tue-minh/MM_Control/Board_Pinout.png

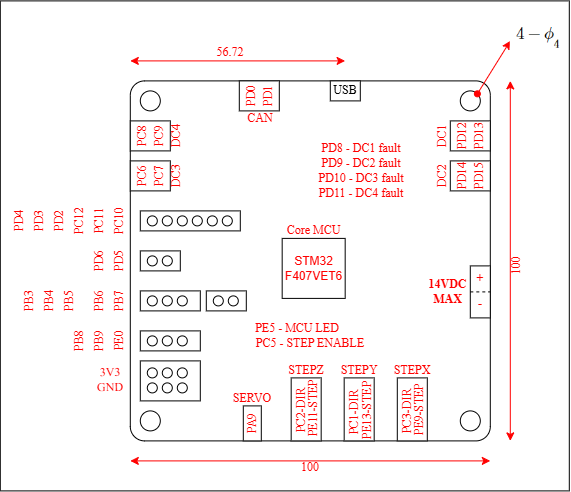
Board_Pinout.png
