tue-minh/MM_Control/hardware/Drawing1.dxf

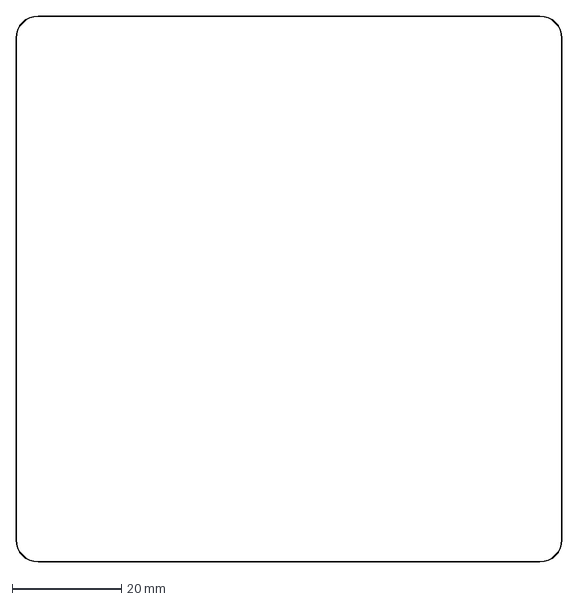
[picture p2: CAD file, 2026-09-20]
hardware/Drawing1.dxf
100.0 x 100.0 mm
