tue-minh/MM_Control/hardware/MM_Control.kicad_pcb

## KiCad design hardware/MM_Control.kicad_pcb (2026-09-20)

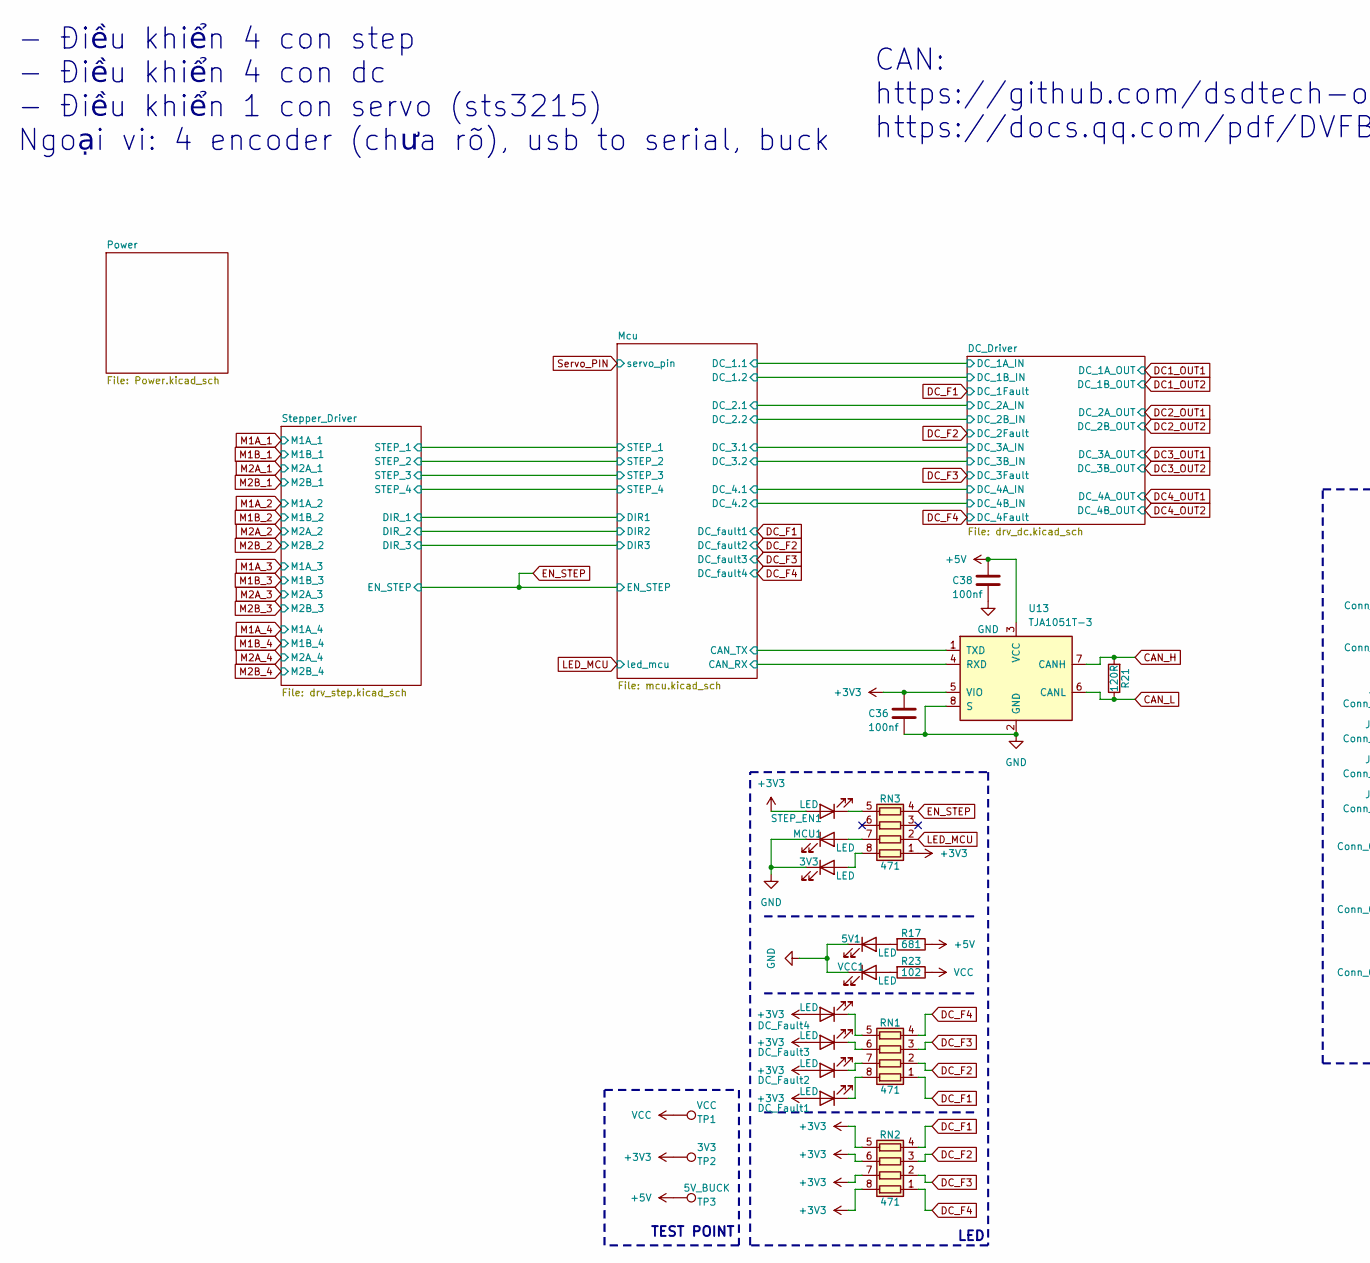
[picture p3: schematic MM_Control.kicad_sch, part in row 1, column 1]

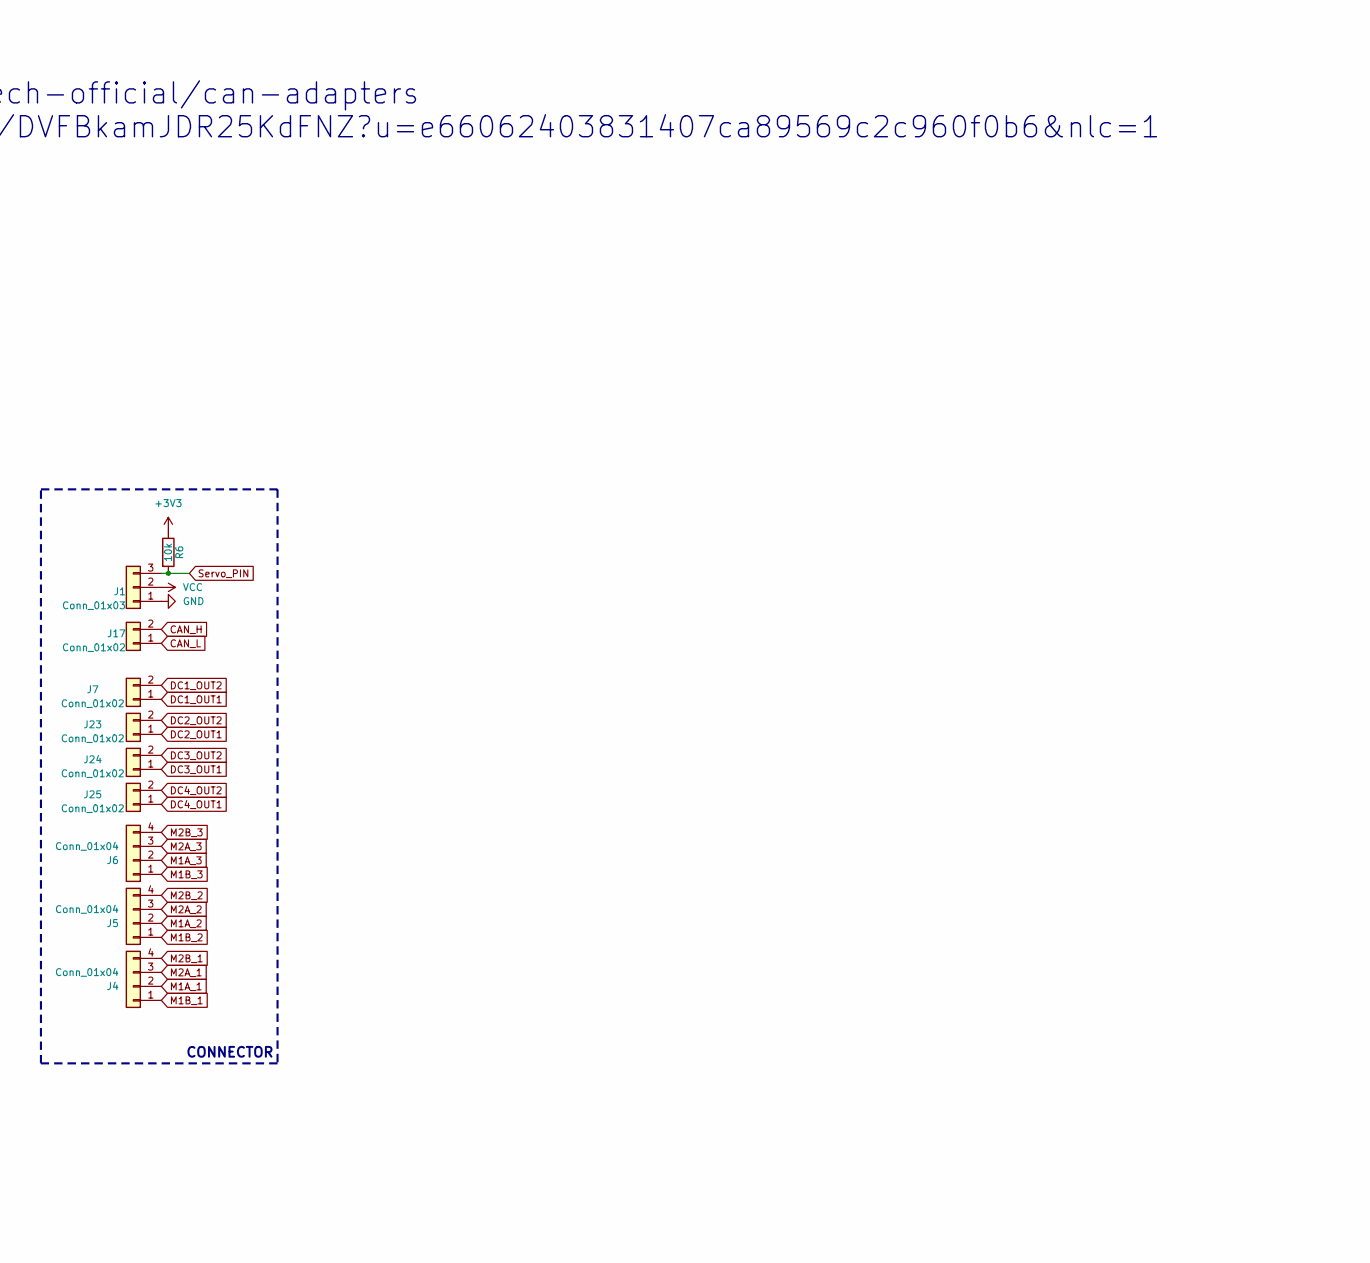
[picture p4: schematic MM_Control.kicad_sch, part in row 1, column 2]

Parts:
3V3, 5V1: LED; LED_0603_1608Metric_Pad1.05x0.95mm_HandSolder
C36, C38: 100nf; C_0603_1608Metric_Pad1.08x0.95mm_HandSolder
DC_Fault1, DC_Fault2, DC_Fault3, DC_Fault4: LED; LED_0603_1608Metric_Pad1.05x0.95mm_HandSolder
J1: Conn_01x03; Molex_SPOX_5267-03A_1x03_P2.50mm_Vertical
J4, J5, J6: Conn_01x04; JST_XH_B4B-XH-A_1x04_P2.50mm_Vertical
J7, J23, J24, J25: Conn_01x02; TerminalBlock_Phoenix_MKDS-1,5-2-5.08_1x02_P5.08mm_Horizont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
J17: Conn_01x02; TerminalBlock_MaiXu_MX126-5.0-02P_1x02_P5.00mm
MCU1: LED; LED_0603_1608Metric_Pad1.05x0.95mm_HandSolder
R6: 10k; R_0603_1608Metric_Pad0.98x0.95mm_HandSolder
R17: 681; R_0603_1608Metric_Pad0.98x0.95mm_HandSolder
R21: 120R; R_0603_1608Metric_Pad0.98x0.95mm_HandSolder
R23: 102; R_0603_1608Metric_Pad0.98x0.95mm_HandSolder
RN1, RN2, RN3: 471; R_Array_Concave_4x0603
STEP_EN1: LED; LED_0603_1608Metric_Pad1.05x0.95mm_HandSolder
TP1: VCC; TestPoint_Pad_D2.0mm
TP2: 3V3; TestPoint_Pad_D2.0mm
TP3: 5V_BUCK; TestPoint_Pad_D2.0mm
U13: TJA1051T-3; SOIC-8_3.9x4.9mm_P1.27mm
VCC1: LED; LED_0603_1608Metric_Pad1.05x0.95mm_HandSolder

Connections:
+3V3: C36.2, DC_Fault1.2 (A), DC_Fault2.2 (A), DC_Fault3.2 (A), DC_Fault4.2 (A), R6.1, RN2.5 (R4.2), RN2.6 (R3.2), RN2.7 (R2.2), RN2.8 (R1.2), RN3.1 (R1.1), STEP_EN1.2 (A), TP2.1, U13.5 (VIO); also elsewhere on the board
+5V: C38.2, R17.1, TP3.1, U13.3 (VCC); also elsewhere on the board
/Mcu/CAN_RX: U13.4 (RXD); also elsewhere on the board
/Mcu/CAN_TX: U13.1 (TXD); also elsewhere on the board
CAN_H: J17.2, R21.2, U13.7 (CANH)
CAN_L: J17.1, R21.1, U13.6 (CANL)
DC1_OUT1: J7.1; also elsewhere on the board
DC1_OUT2: J7.2; also elsewhere on the board
DC2_OUT1: J23.1; also elsewhere on the board
DC2_OUT2: J23.2; also elsewhere on the board
DC3_OUT1: J24.1; also elsewhere on the board
DC3_OUT2: J24.2; also elsewhere on the board
DC4_OUT1: J25.1; also elsewhere on the board
DC4_OUT2: J25.2; also elsewhere on the board
DC_F1: RN1.1 (R1.1), RN2.4 (R4.1); also elsewhere on the board
DC_F2: RN1.2 (R2.1), RN2.3 (R3.1); also elsewhere on the board
DC_F3: RN1.3 (R3.1), RN2.2 (R2.1); also elsewhere on the board
DC_F4: RN1.4 (R4.1), RN2.1 (R1.1); also elsewhere on the board
EN_STEP: RN3.4 (R4.1); also elsewhere on the board
GND: 3V3.1 (K), 5V1.1 (K), C36.1, C38.1, J1.1, MCU1.1 (K), U13.2 (GND), U13.8 (S), VCC1.1 (K); also elsewhere on the board
LED_MCU: RN3.2 (R2.1); also elsewhere on the board
M1A_1: J4.2; also elsewhere on the board
M1A_2: J5.2; also elsewhere on the board
M1A_3: J6.2; also elsewhere on the board
M1B_1: J4.1; also elsewhere on the board
M1B_2: J5.1; also elsewhere on the board
M1B_3: J6.1; also elsewhere on the board
M2A_1: J4.3; also elsewhere on the board
M2A_2: J5.3; also elsewhere on the board
M2A_3: J6.3; also elsewhere on the board
M2B_1: J4.4; also elsewhere on the board
M2B_2: J5.4; also elsewhere on the board
M2B_3: J6.4; also elsewhere on the board
unnamed: 3V3.2 (A), RN3.8 (R1.2)
unnamed: 5V1.2 (A), R17.2
unnamed: DC_Fault1.1 (K), RN1.8 (R1.2)
unnamed: DC_Fault2.1 (K), RN1.7 (R2.2)
unnamed: DC_Fault3.1 (K), RN1.6 (R3.2)
unnamed: DC_Fault4.1 (K), RN1.5 (R4.2)
unnamed: MCU1.2 (A), RN3.7 (R2.2)
unnamed: RN3.5 (R4.2), STEP_EN1.1 (K)
unnamed: R23.2, VCC1.2 (A)
Servo_PIN: J1.3, R6.2; also elsewhere on the board
VM1: J1.2, R23.1, TP1.1; also elsewhere on the board

Notes on the sheet:
TEST POINT
CAN: https://github.com/dsdtech-official/can-adapters https://docs.qq.com/pdf/DVFBkamJDR25KdFNZ?u=e66062403831407ca89569c2c960f0b6&nlc=1
CONNECTOR
LED
- Điều khiển 4 con step - Điều khiển 4 con dc - Điều khiển 1 con servo (sts3215) Ngoại vi: 4 encoder (chưa rõ), usb to serial, buck

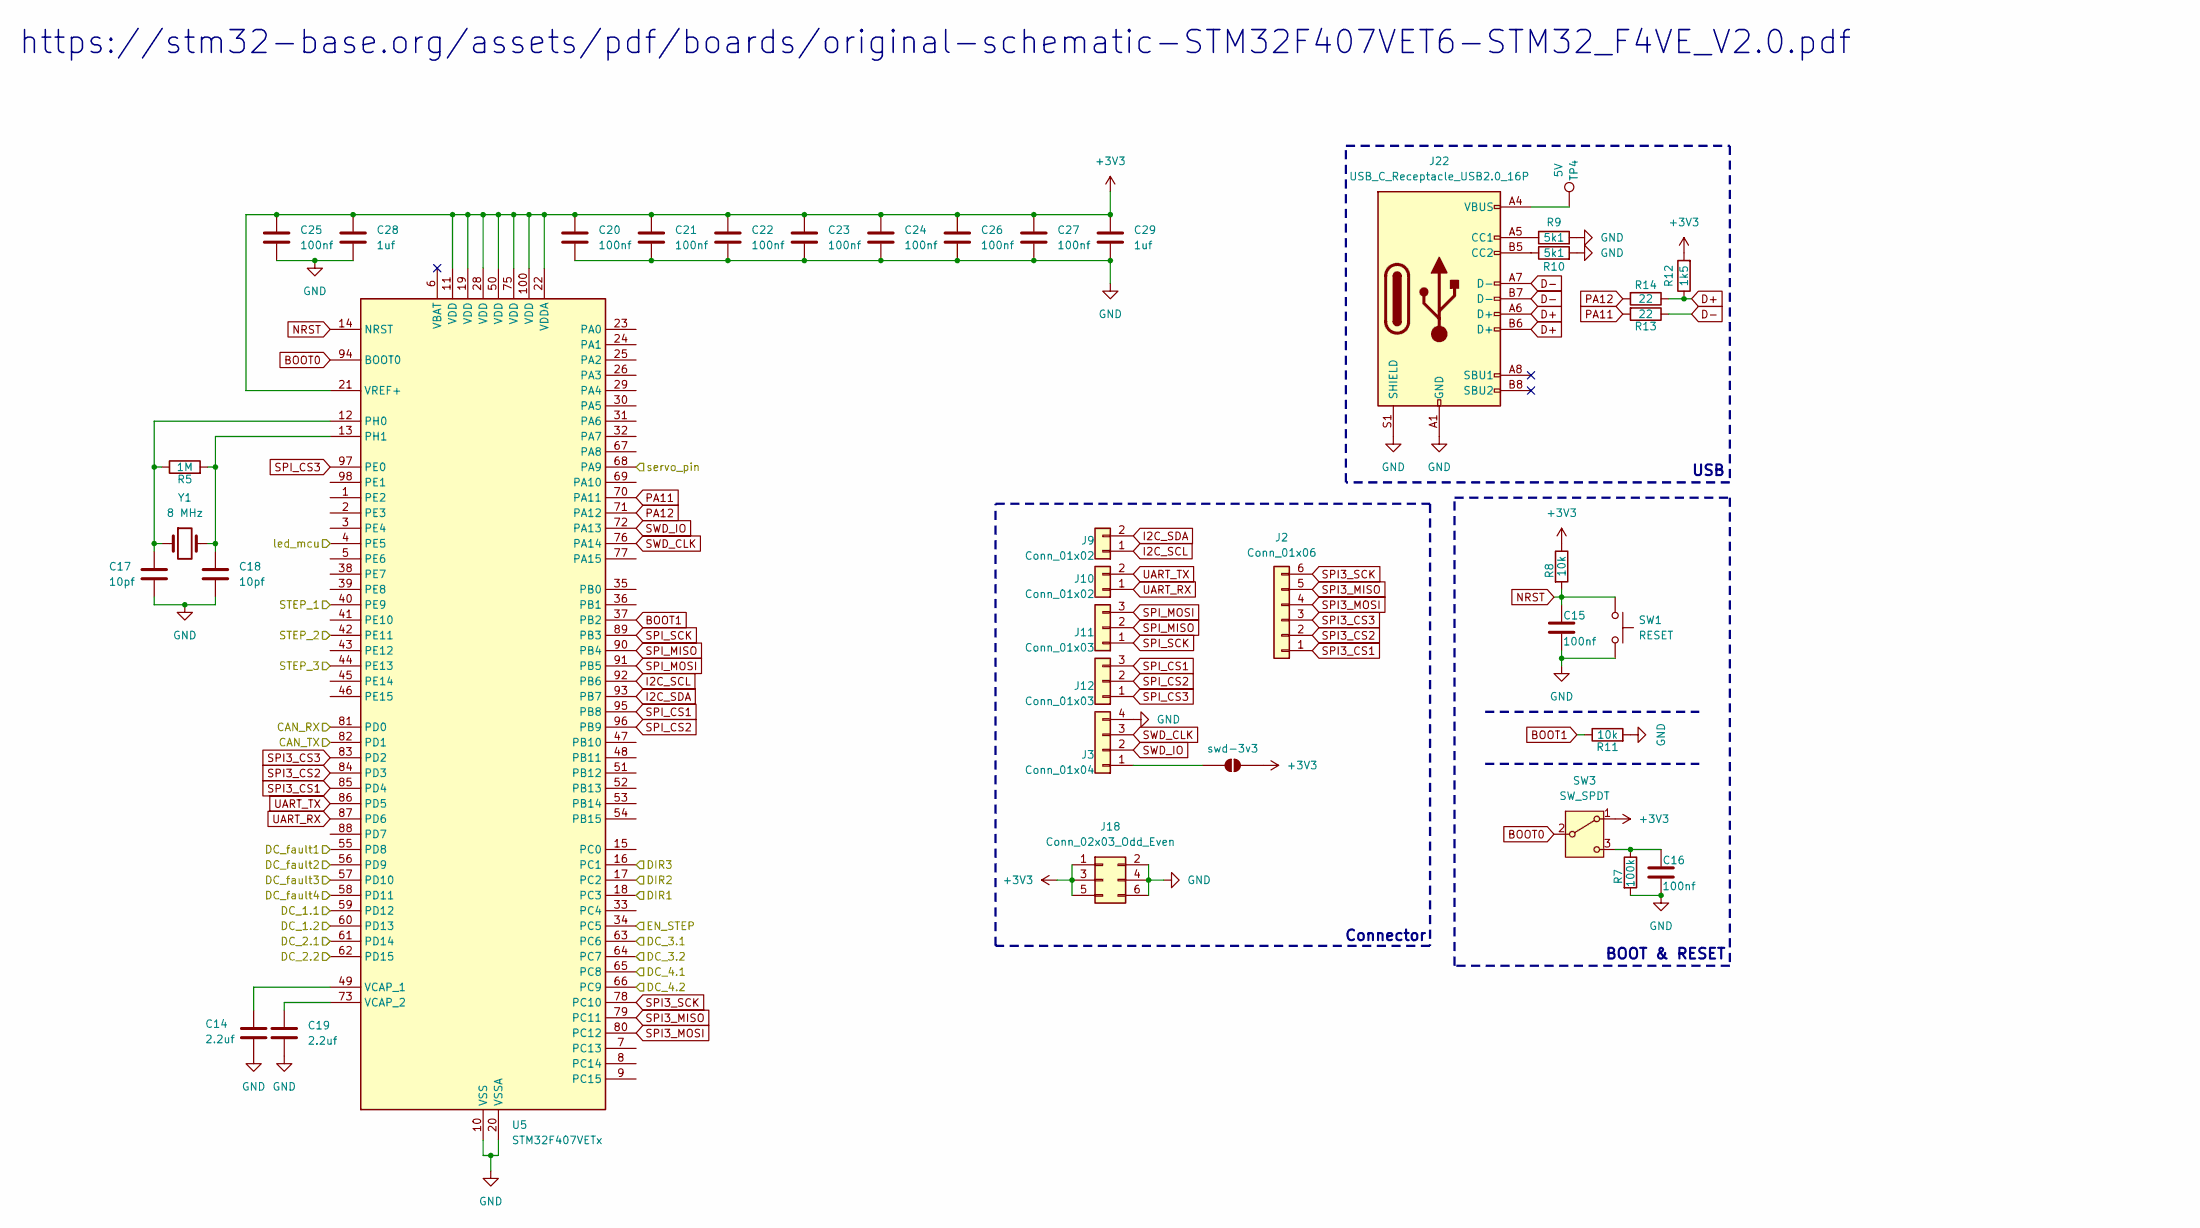
[picture p5: schematic mcu.kicad_sch]

Parts:
C14, C19: 2.2uf; C_0603_1608Metric_Pad1.08x0.95mm_HandSolder
C15, C16, C20, C21, C22, C23, C24, C25, C26, C27: 100nf; C_0603_1608Metric_Pad1.08x0.95mm_HandSolder
C17, C18: 10pf; C_0603_1608Metric_Pad1.08x0.95mm_HandSolder
C28, C29: 1uf; C_0603_1608Metric_Pad1.08x0.95mm_HandSolder
J2: Conn_01x06; PinHeader_1x06_P2.54mm_Vertical
J3: Conn_01x04; PinHeader_1x04_P2.54mm_Vertical
J9, J10: Conn_01x02; PinHeader_1x02_P2.54mm_Vertical
J11, J12: Conn_01x03; PinHeader_1x03_P2.54mm_Vertical
J18: Conn_02x03_Odd_Even; PinHeader_2x03_P2.54mm_Vertical
J22: USB_C_Receptacle_USB2.0_16P; USB_C_Receptacle_GCT_USB4105-xx-A_16P_TopMnt_Horizontal
R5: 1M; R_0603_1608Metric_Pad0.98x0.95mm_HandSolder
R7: 100k; R_0603_1608Metric_Pad0.98x0.95mm_HandSolder
R8, R11: 10k; R_0603_1608Metric_Pad0.98x0.95mm_HandSolder
R9, R10: 5k1; R_0603_1608Metric_Pad0.98x0.95mm_HandSolder
R12: 1k5; R_0603_1608Metric_Pad0.98x0.95mm_HandSolder
R13, R14: 22; R_0603_1608Metric_Pad0.98x0.95mm_HandSolder
SW1: RESET; tue_sw_smd_3x6x2.5mm
SW3: SW_SPDT; tue_SS12D00_3P_2.5mm
TP4: 5V; TestPoint_Pad_D2.0mm
U5: STM32F407VETx; LQFP-100_14x14mm_P0.5mm
Y1: 8 MHz; Crystal_HC49-4H_Vertical
swd-3v3: SolderJumper_2_Open; SolderJumper-2_P1.3mm_Open_RoundedPad1.0x1.5mm

Connections:
+3V3: C20.1, C21.1, C22.1, C23.1, C24.1, C25.1, C26.1, C27.1, C28.1, C29.1, J18.1, J18.3, J18.5, R8.1, R12.2, SW3.1 (A), U5.11 (VDD), U5.19 (VDD), U5.21 (VREF+), U5.22 (VDDA), U5.28 (VDD), U5.50 (VDD), U5.75 (VDD), U5.100 (VDD), swd-3v3.2 (B); also elsewhere on the board
/DC_Driver/DC_1A_IN: U5.59 (PD12); also elsewhere on the board
/DC_Driver/DC_1B_IN: U5.60 (PD13); also elsewhere on the board
/DC_Driver/DC_2A_IN: U5.61 (PD14); also elsewhere on the board
/DC_Driver/DC_2B_IN: U5.62 (PD15); also elsewhere on the board
/DC_Driver/DC_3A_IN: U5.63 (PC6); also elsewhere on the board
/DC_Driver/DC_3B_IN: U5.64 (PC7); also elsewhere on the board
/DC_Driver/DC_4A_IN: U5.65 (PC8); also elsewhere on the board
/DC_Driver/DC_4B_IN: U5.66 (PC9); also elsewhere on the board
/Mcu/CAN_RX: U5.81 (PD0); also elsewhere on the board
/Mcu/CAN_TX: U5.82 (PD1); also elsewhere on the board
/Mcu/DIR1: U5.18 (PC3); also elsewhere on the board
/Mcu/DIR2: U5.17 (PC2); also elsewhere on the board
/Mcu/DIR3: U5.16 (PC1); also elsewhere on the board
/Mcu/STEP_1: U5.40 (PE9); also elsewhere on the board
/Mcu/STEP_2: U5.42 (PE11); also elsewhere on the board
/Mcu/STEP_3: U5.44 (PE13); also elsewhere on the board
BOOT0: SW3.2 (B), U5.94 (BOOT0)
BOOT1: R11.1, U5.37 (PB2)
D+: J22.A6 (D+), J22.B6 (D+), R12.1, R14.1
D-: J22.A7 (D-), J22.B7 (D-), R13.1
DC_F1: U5.55 (PD8); also elsewhere on the board
DC_F2: U5.56 (PD9); also elsewhere on the board
DC_F3: U5.57 (PD10); also elsewhere on the board
DC_F4: U5.58 (PD11); also elsewhere on the board
EN_STEP: U5.34 (PC5); also elsewhere on the board
GND: C14.2, C15.2, C16.2, C17.1, C18.2, C19.2, C20.2, C21.2, C22.2, C23.2, C24.2, C25.2, C26.2, C27.2, C28.2, C29.2, J3.4, J18.2, J18.4, J18.6, J22.A1 (GND), J22.A12 (GND), J22.B1 (GND), J22.B12 (GND), J22.S1 (SHIELD), R7.2, R9.2, R10.2, R11.2, SW1.2, U5.10 (VSS), U5.20 (VSSA), U5.27 (VSS), U5.74 (VSS), U5.99 (VSS); also elsewhere on the board
I2C_SCL: J9.1, U5.92 (PB6)
I2C_SDA: J9.2, U5.93 (PB7)
LED_MCU: U5.4 (PE5); also elsewhere on the board
NRST: C15.1, R8.2, SW1.1, U5.14 (NRST)
unnamed: J3.1, swd-3v3.1 (A)
unnamed: J22.A5 (CC1), R9.1
unnamed: J22.B5 (CC2), R10.1
unnamed: J22.A4 (VBUS), J22.A9 (VBUS), J22.B4 (VBUS), J22.B9 (VBUS), TP4.1
unnamed: C16.1, R7.1, SW3.3 (C)
unnamed: C17.2, R5.1, U5.12 (PH0), Y1.1
unnamed: C18.1, R5.2, U5.13 (PH1), Y1.2
unnamed: C14.1, U5.49 (VCAP_1)
unnamed: C19.1, U5.73 (VCAP_2)
PA11: R13.2, U5.70 (PA11)
PA12: R14.2, U5.71 (PA12)
SPI3_CS1: J2.1, U5.85 (PD4)
SPI3_CS2: J2.2, U5.84 (PD3)
SPI3_CS3: J2.3, U5.83 (PD2)
SPI3_MISO: J2.5, U5.79 (PC11)
SPI3_MOSI: J2.4, U5.80 (PC12)
SPI3_SCK: J2.6, U5.78 (PC10)
SPI_CS1: J12.3, U5.95 (PB8)
SPI_CS2: J12.2, U5.96 (PB9)
SPI_CS3: J12.1, U5.97 (PE0)
SPI_MISO: J11.2, U5.90 (PB4)
SPI_MOSI: J11.3, U5.91 (PB5)
SPI_SCK: J11.1, U5.89 (PB3)
SWD_CLK: J3.3, U5.76 (PA14)
SWD_IO: J3.2, U5.72 (PA13)
Servo_PIN: U5.68 (PA9); also elsewhere on the board
UART_RX: J10.1, U5.87 (PD6)
UART_TX: J10.2, U5.86 (PD5)

Notes on the sheet:
Connector
https://stm32-base.org/assets/pdf/boards/original-schematic-STM32F407VET6-STM32_F4VE_V2.0.pdf
BOOT & RESET
USB

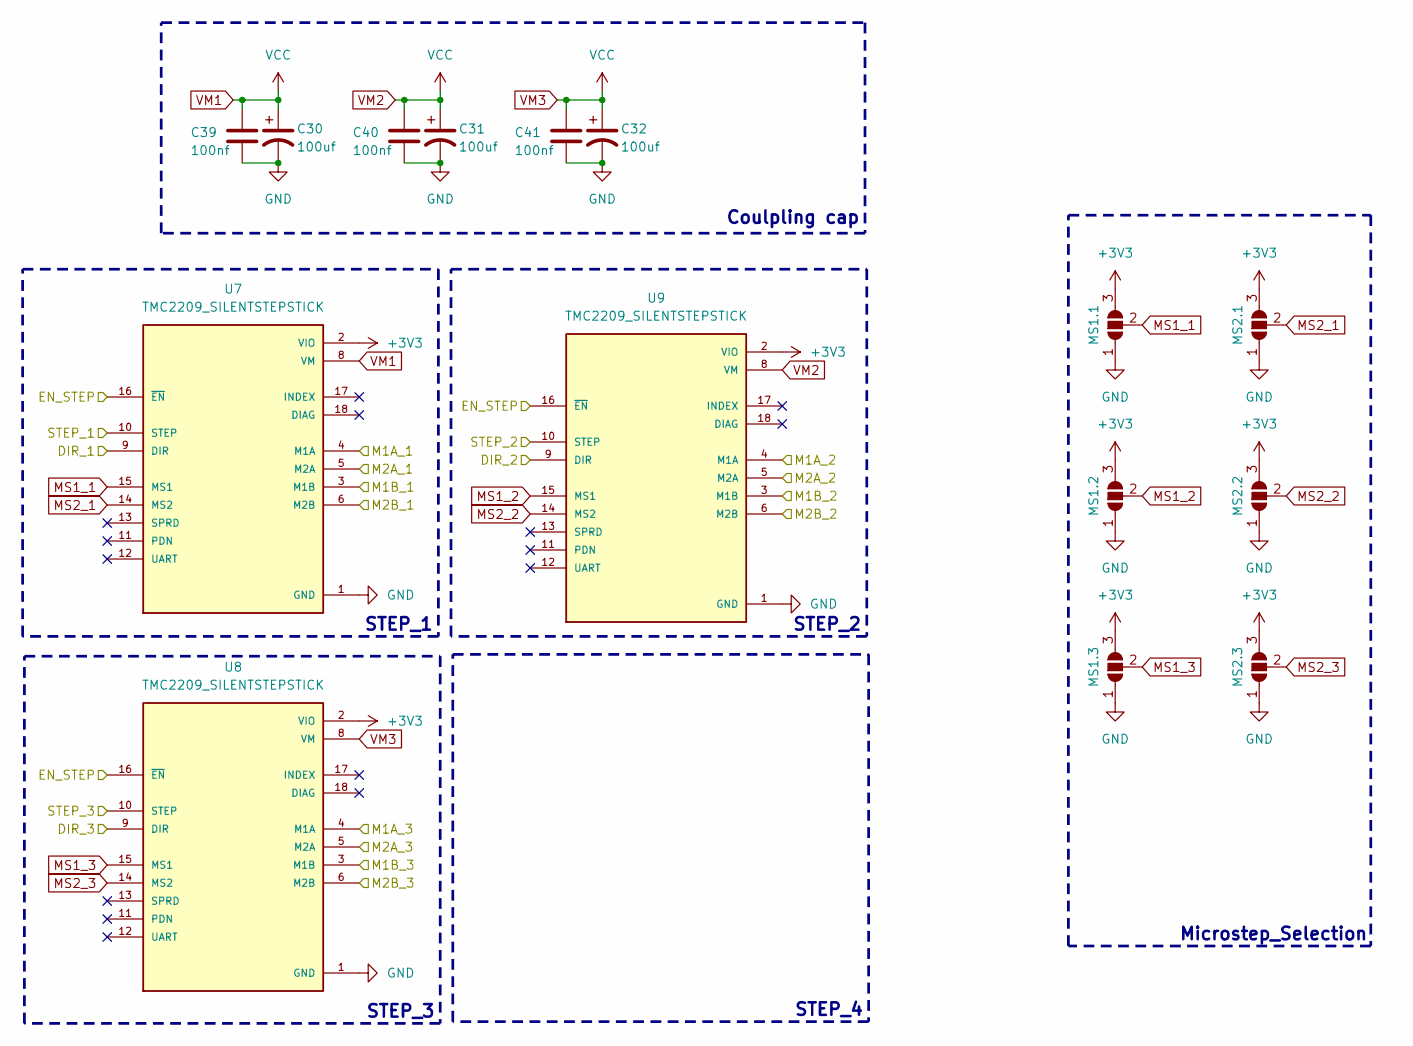
[picture p6: schematic drv_step.kicad_sch]

Parts:
C30, C31, C32: 100uf; CP_Elec_6.3x5.9
C39, C40, C41: 100nf; C_1206_3216Metric_Pad1.33x1.80mm_HandSolder
MS1.1, MS1.2, MS1.3, MS2.1, MS2.2, MS2.3: MicroStep_Selection; SolderJumper-3_P1.3mm_Open_RoundedPad1.0x1.5mm
U7, U8, U9: TMC2209_SILENTSTEPSTICK; tue_TMC2209; PARTREV 1.20

Connections:
+3V3: MS1.1.3 (B), MS1.2.3 (B), MS1.3.3 (B), MS2.1.3 (B), MS2.2.3 (B), MS2.3.3 (B), U7.2 (VIO), U8.2 (VIO), U9.2 (VIO); also elsewhere on the board
/Mcu/DIR1: U7.9 (DIR); also elsewhere on the board
/Mcu/DIR2: U9.9 (DIR); also elsewhere on the board
/Mcu/DIR3: U8.9 (DIR); also elsewhere on the board
/Mcu/STEP_1: U7.10 (STEP); also elsewhere on the board
/Mcu/STEP_2: U9.10 (STEP); also elsewhere on the board
/Mcu/STEP_3: U8.10 (STEP); also elsewhere on the board
EN_STEP: U7.16 (~EN), U8.16 (~EN), U9.16 (~EN); also elsewhere on the board
GND: C30.2, C31.2, C32.2, C39.1, C40.1, C41.1, MS1.1.1 (A), MS1.2.1 (A), MS1.3.1 (A), MS2.1.1 (A), MS2.2.1 (A), MS2.3.1 (A), U7.1 (GND), U7.7 (GND), U8.1 (GND), U8.7 (GND), U9.1 (GND), U9.7 (GND); also elsewhere on the board
M1A_1: U7.4 (M1A); also elsewhere on the board
M1A_2: U9.4 (M1A); also elsewhere on the board
M1A_3: U8.4 (M1A); also elsewhere on the board
M1B_1: U7.3 (M1B); also elsewhere on the board
M1B_2: U9.3 (M1B); also elsewhere on the board
M1B_3: U8.3 (M1B); also elsewhere on the board
M2A_1: U7.5 (M2A); also elsewhere on the board
M2A_2: U9.5 (M2A); also elsewhere on the board
M2A_3: U8.5 (M2A); also elsewhere on the board
M2B_1: U7.6 (M2B); also elsewhere on the board
M2B_2: U9.6 (M2B); also elsewhere on the board
M2B_3: U8.6 (M2B); also elsewhere on the board
MS1_1: MS1.1.2 (C), U7.15 (MS1)
MS1_2: MS1.2.2 (C), U9.15 (MS1)
MS1_3: MS1.3.2 (C), U8.15 (MS1)
MS2_1: MS2.1.2 (C), U7.14 (MS2)
MS2_2: MS2.2.2 (C), U9.14 (MS2)
MS2_3: MS2.3.2 (C), U8.14 (MS2)
VM1: C30.1, C31.1, C32.1, C39.2, C40.2, C41.2, U7.8 (VM), U8.8 (VM), U9.8 (VM); also elsewhere on the board

Notes on the sheet:
STEP_4
STEP_1
Coulpling cap
STEP_3
Microstep_Selection
STEP_2

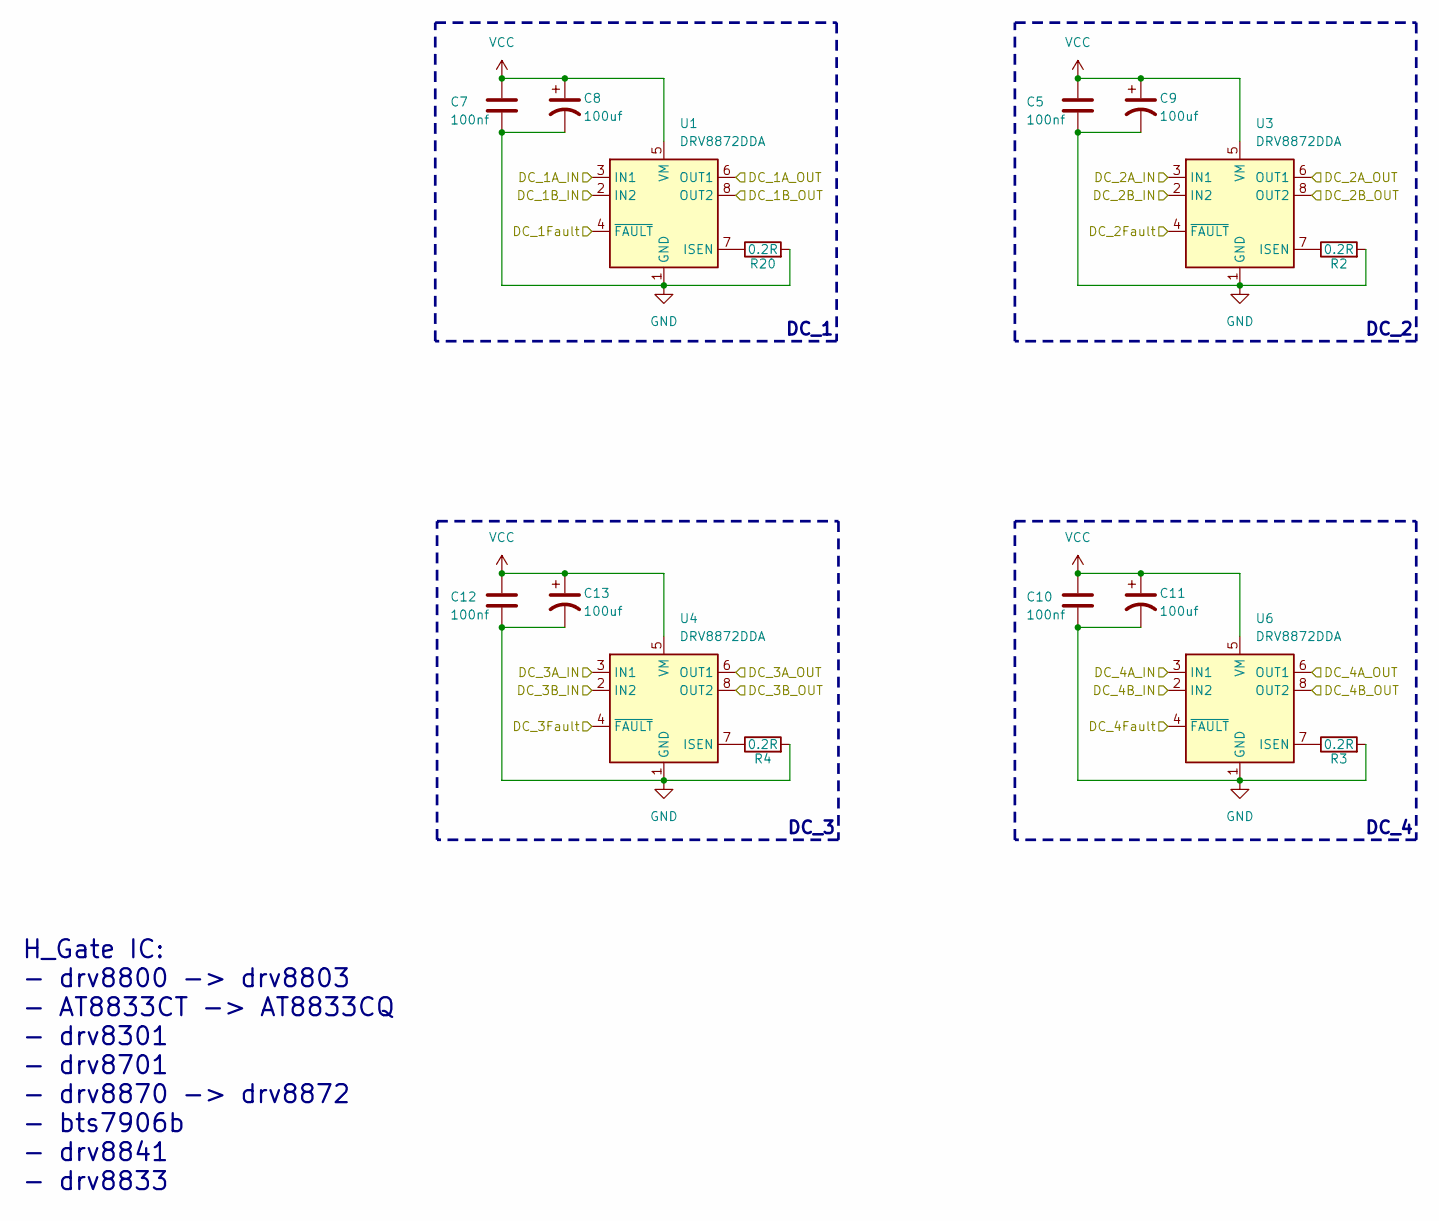
[picture p7: schematic drv_dc.kicad_sch]

Parts:
C5, C7, C10, C12: 100nf; C_1206_3216Metric_Pad1.33x1.80mm_HandSolder
C8, C9, C11, C13: 100uf; CP_Elec_6.3x5.9
R2, R3, R4, R20: 0.2R; R_2512_6332Metric_Pad1.40x3.35mm_HandSolder
U1, U3, U4, U6: DRV8872DDA; Texas_HTSOP-8-1EP_3.9x4.9mm_P1.27mm_EP2.95x4.9mm_Mask2.4x3.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

Connections:
/DC_Driver/DC_1A_IN: U1.3 (IN1); also elsewhere on the board
/DC_Driver/DC_1B_IN: U1.2 (IN2); also elsewhere on the board
/DC_Driver/DC_2A_IN: U3.3 (IN1); also elsewhere on the board
/DC_Driver/DC_2B_IN: U3.2 (IN2); also elsewhere on the board
/DC_Driver/DC_3A_IN: U4.3 (IN1); also elsewhere on the board
/DC_Driver/DC_3B_IN: U4.2 (IN2); also elsewhere on the board
/DC_Driver/DC_4A_IN: U6.3 (IN1); also elsewhere on the board
/DC_Driver/DC_4B_IN: U6.2 (IN2); also elsewhere on the board
DC1_OUT1: U1.6 (OUT1); also elsewhere on the board
DC1_OUT2: U1.8 (OUT2); also elsewhere on the board
DC2_OUT1: U3.6 (OUT1); also elsewhere on the board
DC2_OUT2: U3.8 (OUT2); also elsewhere on the board
DC3_OUT1: U4.6 (OUT1); also elsewhere on the board
DC3_OUT2: U4.8 (OUT2); also elsewhere on the board
DC4_OUT1: U6.6 (OUT1); also elsewhere on the board
DC4_OUT2: U6.8 (OUT2); also elsewhere on the board
DC_F1: U1.4 (~FAULT); also elsewhere on the board
DC_F2: U3.4 (~FAULT); also elsewhere on the board
DC_F3: U4.4 (~FAULT); also elsewhere on the board
DC_F4: U6.4 (~FAULT); also elsewhere on the board
GND: C5.1, C7.1, C8.2, C9.2, C10.1, C11.2, C12.1, C13.2, R2.2, R3.2, R4.2, R20.2, U1.1 (GND), U1.9 (GND), U3.1 (GND), U3.9 (GND), U4.1 (GND), U4.9 (GND), U6.1 (GND), U6.9 (GND); also elsewhere on the board
unnamed: R20.1, U1.7 (ISEN)
unnamed: R2.1, U3.7 (ISEN)
unnamed: R4.1, U4.7 (ISEN)
unnamed: R3.1, U6.7 (ISEN)
VM1: C5.2, C7.2, C8.1, C9.1, C10.2, C11.1, C12.2, C13.1, U1.5 (VM), U3.5 (VM), U4.5 (VM), U6.5 (VM); also elsewhere on the board

Notes on the sheet:
DC_3
DC_1
DC_2
H_Gate IC: - drv8800 -> drv8803 - AT8833CT -> AT8833CQ - drv8301 - drv8701 - drv8870 -> drv8872 - bts7906b - drv8841 - drv8833
DC_4

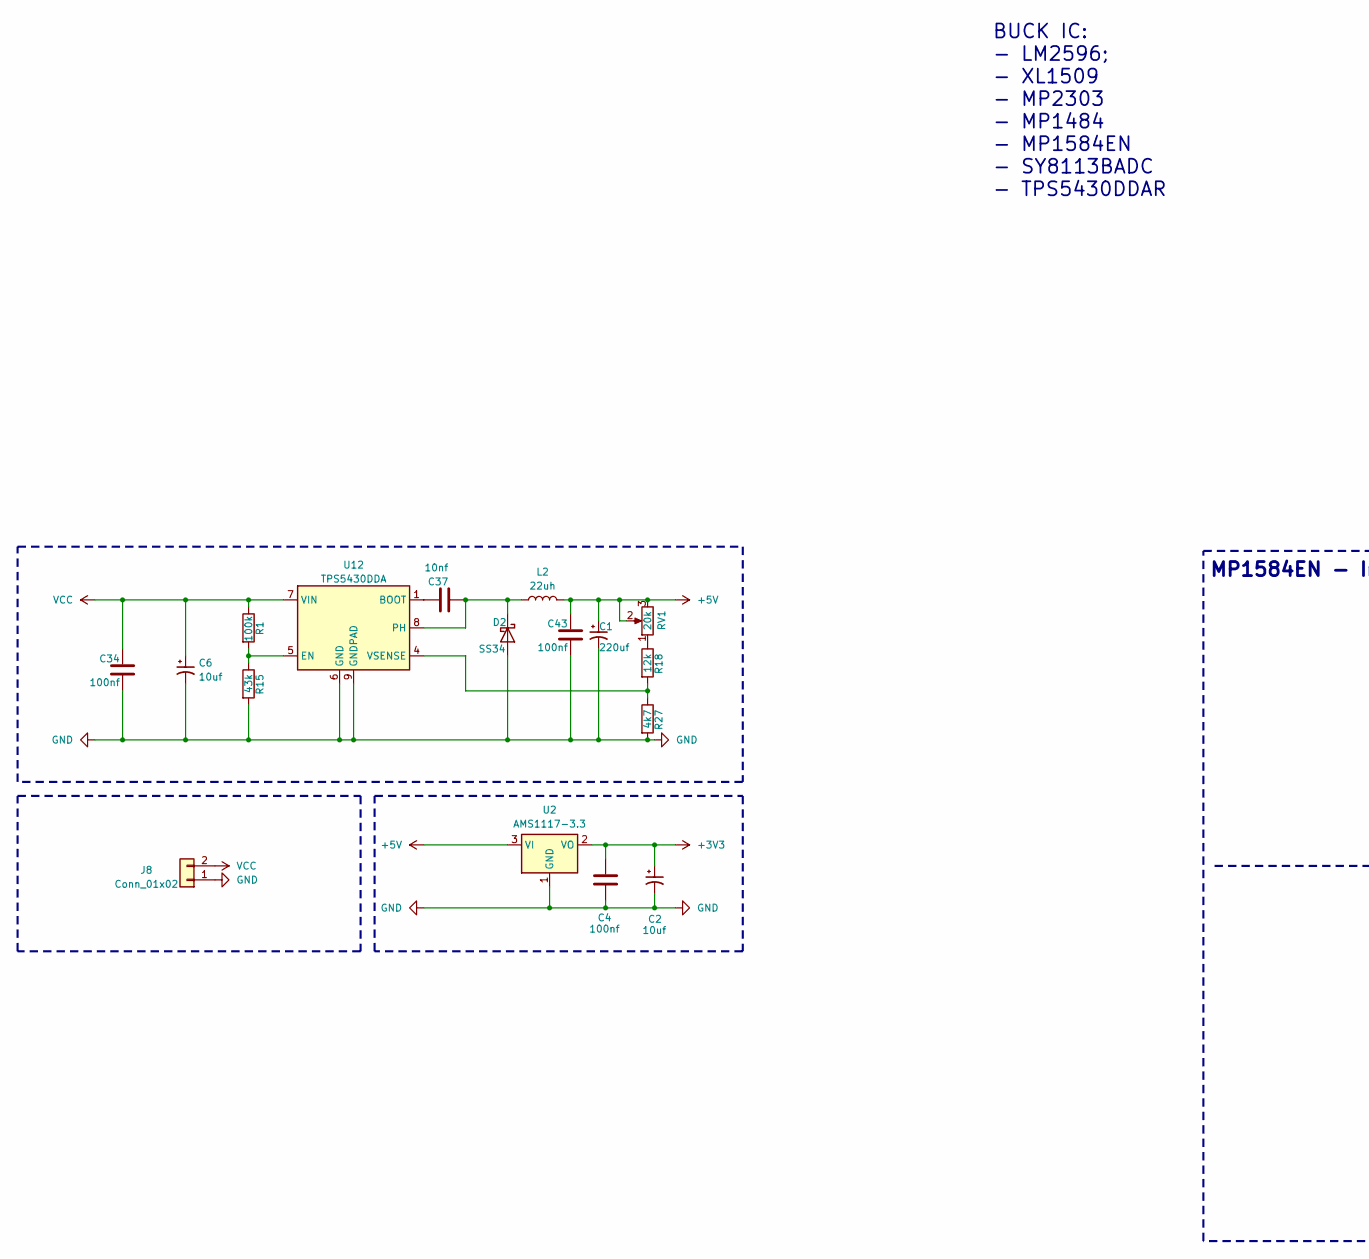
[picture p8: schematic Power.kicad_sch, part in row 1, column 1]

Parts:
C1: 220uf; CP_Elec_6.3x7.7
C2, C6: 10uf; CP_EIA-3216-18_Kemet-A_HandSolder
C4, C34, C43: 100nf; C_1206_3216Metric_Pad1.33x1.80mm_HandSolder
C37: 10nf; C_0603_1608Metric_Pad1.08x0.95mm_HandSolder
D2: SS34; D_SMA
J8: Conn_01x02; TerminalBlock_Phoenix_MKDS-1,5-2-5.08_1x02_P5.08mm_Horizont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
L2: 22uh; L_10.4x10.4_H4.8
R1: 100k; R_0603_1608Metric_Pad0.98x0.95mm_HandSolder
R15: 43k; R_0603_1608Metric_Pad0.98x0.95mm_HandSolder
R18: 12k; R_0603_1608Metric_Pad0.98x0.95mm_HandSolder
R27: 4k7; R_0603_1608Metric_Pad0.98x0.95mm_HandSolder
RV1: 20k; Potentiometer_Bourns_3296W_Vertical
U2: AMS1117-3.3; SOT-223-3_TabPin2
U12: TPS5430DDA; TI_SO-PowerPAD-8_ThermalVias

Connections:
+3V3: C2.1, C4.2, U2.2 (VO); also elsewhere on the board
+5V: C1.1, C43.2, L2.2, RV1.2, RV1.3, U2.3 (VI); also elsewhere on the board
GND: C1.2, C2.2, C4.1, C6.2, C34.1, C43.1, D2.2 (A), J8.1, R15.2, R27.2, U2.1 (GND), U12.6 (GND), U12.9 (GNDPAD); also elsewhere on the board
unnamed: C37.1, D2.1 (K), L2.1, U12.8 (PH)
unnamed: R18.1, RV1.1
unnamed: C37.2, U12.1 (BOOT)
unnamed: R1.2, R15.1, U12.5 (EN)
unnamed: R18.2, R27.1, U12.4 (VSENSE)
VM1: C6.1, C34.2, J8.2, R1.1, U12.7 (VIN); also elsewhere on the board

Notes on the sheet:
MP1584EN - Instruction
R=360 (kOhm) -> f=500 (kHz)
BUCK IC: - LM2596; - XL1509 - MP2303 - MP1484 - MP1584EN - SY8113BADC - TPS5430DDAR
