tue-minh/MM_Control/firmware/Core/Inc/tue_stepper.h

#define __TUE_STEPPER_H__
#ifdef __cplusplus
extern "C" {
#endif
#include <stdbool.h>
#include <stdint.h>
#include "main.h"
#include "tim.h"
#define TUE_STEPPER_GT2_PITCH_MM        2.0f
#define TUE_STEPPER_MICROSTEPS          16U
#define TUE_STEPPER_MOTOR_FULL_STEPS    200U
#define TUE_STEPPER_XY_TEETH            20U
#define TUE_STEPPER_Z_LEAD_MM           8.0f
#define TUE_STEPPER_STEPS_PER_REV       ((float)(TUE_STEPPER_MOTOR_FULL_STEPS * TUE_STEPPER_MICROSTEPS))
#define TUE_STEPPER_XY_MM_PER_REV       (TUE_STEPPER_GT2_PITCH_MM * (float)TUE_STEPPER_XY_TEETH)
#define TUE_STEPPER_XY_STEPS_PER_MM     (TUE_STEPPER_STEPS_PER_REV / TUE_STEPPER_XY_MM_PER_REV)
#define TUE_STEPPER_XY_MM_PER_STEP      (TUE_STEPPER_XY_MM_PER_REV / TUE_STEPPER_STEPS_PER_REV)
#define TUE_STEPPER_Z_STEPS_PER_MM      (TUE_STEPPER_STEPS_PER_REV / TUE_STEPPER_Z_LEAD_MM)
#define TUE_STEPPER_Z_MM_PER_STEP       (TUE_STEPPER_Z_LEAD_MM / TUE_STEPPER_STEPS_PER_REV)
#define TUE_STEPPER_TIMER_HZ            1000000U
#define TUE_STEPPER_MIN_INTERVAL_US     4U
#define TUE_STEPPER_PULSE_US            3U
#define TUE_STEPPER_MAX_RATE_STEPS_S    50000.0f
#define TUE_STEPPER_MIN_RATE_STEPS_S    400.0f
#define TUE_STEPPER_QUEUE_SIZE          16U
#define TUE_STEPPER_MOTOR_COUNT         3U
#define TUE_STEPPER_EN_ACTIVE_LOW       1
typedef enum {
    TUE_STEPPER_M1 = 0,
    TUE_STEPPER_M2 = 1,
    TUE_STEPPER_M3 = 2
} tue_stepper_motor_t;
typedef enum {
    TUE_STEPPER_OK = 0,
    TUE_STEPPER_ERR_PARAM,
    TUE_STEPPER_ERR_QUEUE_FULL,
    TUE_STEPPER_BUSY,
    TUE_STEPPER_ERR_TIMEOUT
} tue_stepper_status_t;
typedef struct {
    float steps_per_mm[TUE_STEPPER_MOTOR_COUNT];
    bool  invert[TUE_STEPPER_MOTOR_COUNT];
} tue_stepper_config_t;
tue_stepper_config_t tue_stepper_default_config(void);
void tue_stepper_set_config(const tue_stepper_config_t *cfg);
void tue_stepper_get_config(tue_stepper_config_t *cfg);
void tue_stepper_init(void);
void tue_stepper_enable(bool enable);
bool tue_stepper_is_enabled(void);
void tue_stepper_set_position_mm(float x, float y, float z);
void tue_stepper_get_position_mm(float *x, float *y, float *z);
void tue_stepper_get_target_mm(float *x, float *y, float *z);
int32_t tue_stepper_get_motor_steps(tue_stepper_motor_t motor);
int32_t tue_stepper_mm_to_steps_xy(float mm);
int32_t tue_stepper_mm_to_steps_z(float mm);
tue_stepper_status_t tue_stepper_move_to_xyz_mm(float x, float y, float z,
                                                float feed_mm_s, float accel_mm_s2);
tue_stepper_status_t tue_stepper_move_to_mm(float x, float y,
                                            float feed_mm_s, float accel_mm_s2);
tue_stepper_status_t tue_stepper_move_z_mm(float z, float feed_mm_s, float accel_mm_s2);
tue_stepper_status_t tue_stepper_move_by_mm(float dx, float dy,
                                            float feed_mm_s, float accel_mm_s2);
tue_stepper_status_t tue_stepper_move_motor_steps(tue_stepper_motor_t motor,
                                                  int32_t steps,
                                                  float feed_mm_s, float accel_mm_s2);
tue_stepper_status_t tue_stepper_start_velocity(float vx_mm_s, float vy_mm_s,
                                                float accel_mm_s2);
tue_stepper_status_t tue_stepper_start_velocity_z(float vz_mm_s, float accel_mm_s2);
void tue_stepper_stop(void);
void tue_stepper_abort(void);
bool tue_stepper_is_busy(void);
tue_stepper_status_t tue_stepper_wait_idle(uint32_t timeout_ms);
void tue_stepper_on_timer_elapsed(TIM_HandleTypeDef *htim);
#ifdef __cplusplus
}
#endif
