tue-minh/MM_Control/firmware/MM_control.ioc

Mcu.UserName=STM32F407VETx
PA11.Signal=USB_OTG_FS_DM
PA12.Signal=USB_OTG_FS_DP
PA13.Signal=SYS_JTMS-SWDIO
PA14.Signal=SYS_JTCK-SWCLK
PA9.GPIO_Label=SERVO_TX
PA9.Signal=USART1_TX
PB3.Signal=SPI1_SCK
PB4.Signal=SPI1_MISO
PB5.Signal=SPI1_MOSI
PB6.Signal=I2C1_SCL
PB7.Signal=I2C1_SDA
PB8.GPIO_Label=SPI1_CS1
PB8.Signal=GPIO_Output
PB9.GPIO_Label=SPI1_CS2
PB9.Signal=GPIO_Output
PC0.GPIO_Label=STEP_DIR4
PC0.Signal=GPIO_Output
PC1.GPIO_Label=STEP_DIR3
PC1.Signal=GPIO_Output
PC10.Signal=SPI3_SCK
PC11.Signal=SPI3_MISO
PC12.Signal=SPI3_MOSI
PC2.GPIO_Label=STEP_DIR2
PC2.Signal=GPIO_Output
PC3.GPIO_Label=STEP_DIR1
PC3.Signal=GPIO_Output
PC5.GPIO_Label=STEP_ENABLE
PC5.Signal=GPIO_Output
PC6.GPIO_Label=DC-31
PC6.Signal=S_TIM3_CH1
PC7.GPIO_Label=DC_32
PC7.Signal=S_TIM3_CH2
PC8.GPIO_Label=DC_41
PC8.Signal=S_TIM3_CH3
PC9.GPIO_Label=DC_42
PC9.Signal=S_TIM3_CH4
PD0.Signal=CAN1_RX
PD1.Signal=CAN1_TX
PD10.GPIO_Label=DC_F3
PD10.Signal=GPIO_Input
PD11.GPIO_Label=DC_F4
PD11.Signal=GPIO_Input
PD12.GPIO_Label=DC_11
PD12.Signal=S_TIM4_CH1
PD13.GPIO_Label=DC_12
PD13.Signal=S_TIM4_CH2
PD14.GPIO_Label=DC_21
PD14.Signal=S_TIM4_CH3
PD15.GPIO_Label=DC_22
PD15.Signal=S_TIM4_CH4
PD2.GPIO_Label=SPI3_CS1
PD2.Signal=GPIO_Output
PD3.GPIO_Label=SPI3_CS2
PD3.Signal=GPIO_Output
PD4.GPIO_Label=SPI3_CS1
PD4.Signal=GPIO_Output
PD5.Signal=USART2_TX
PD6.Signal=USART2_RX
PD8.GPIO_Label=DC_F1
PD8.Signal=GPIO_Input
PD9.GPIO_Label=DC_F2
PD9.Signal=GPIO_Input
PE0.GPIO_Label=SPI1_CS3
PE0.Signal=GPIO_Output
PE11.GPIO_Label=STEP_2
PE11.Signal=S_TIM1_CH2
PE13.GPIO_Label=STEP_3
PE13.Signal=S_TIM1_CH3
PE14.GPIO_Label=STEP_4
PE14.Signal=S_TIM1_CH4
PE5.GPIO_Label=LED_MCU
PE5.Signal=GPIO_Output
PE9.GPIO_Label=STEP_1
PE9.Signal=S_TIM1_CH1
PH0-OSC_IN.Signal=RCC_OSC_IN
PH1-OSC_OUT.Signal=RCC_OSC_OUT
