tue-minh/MM_Control/(commit log)

2026-09-20 reorganizing system file
    [BOM_MOBILE_ROBOT.xlsx, Drawing1.dxf, MM_Control.kicad_pcb, MM_Control.kicad_sch, Power.kicad_sch, drv_dc.kicad_sch, drv_step.kicad_sch, mcu.kicad_sch]
2026-10-12 Add STS3215 motor support and update firmware/python
2026-10-12 Include additional build changes and new STM32 documentation
2026-10-12 add scan servo file
