tue-minh/MM_Control/(notices)

Notices in the files:
firmware/Core/Src/main.c:
This software is licensed under terms that can be found in the LICENSE file
